junsuk123/MacintoshMini/docs/assets/esp32s3169.png

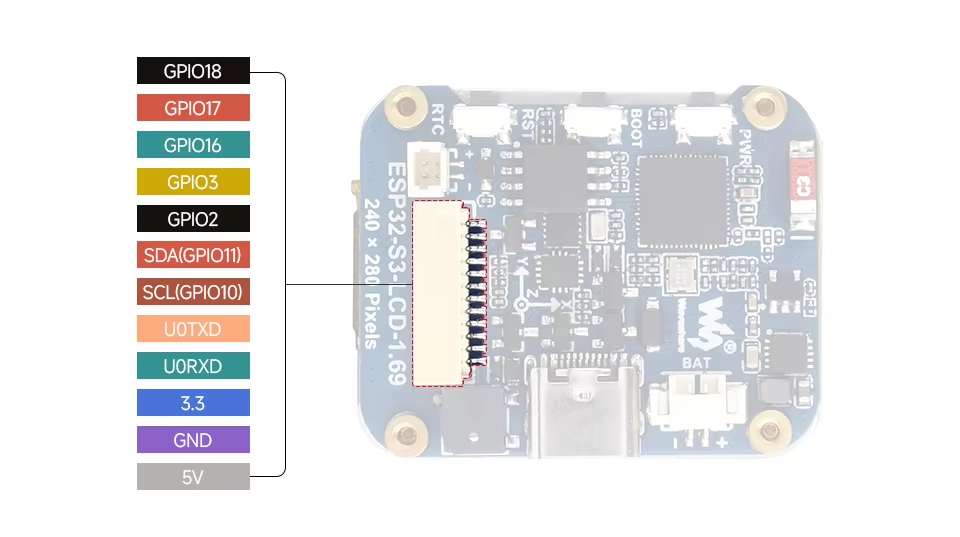
docs/assets/esp32s3169.png
