junsuk123/MacintoshMini/docs/assets/max98357A.png

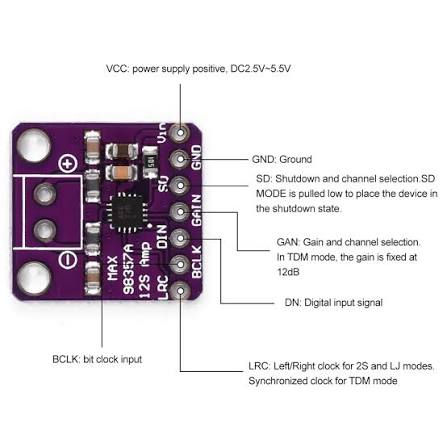
docs/assets/max98357A.png
