junsuk123/MacintoshMini/docs/assets/microSDReader.png

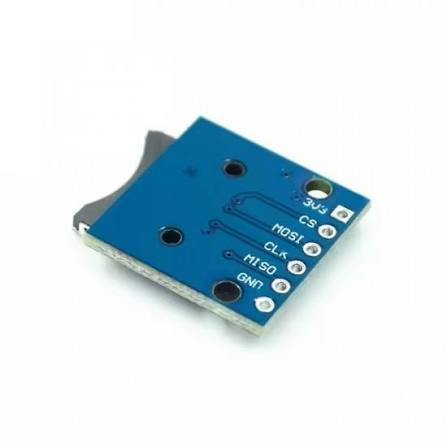
docs/assets/microSDReader.png
