junsuk123/MacintoshMini/(list of files, drawings)

Other design files:
매킨토시Sketch.fzz
