junsuk123/MacintoshMini/firmware/include/config.h

#pragma once

#include <Arduino.h>

namespace cfg {

constexpr uint32_t SerialBaud = 115200;
constexpr uint8_t VideoFps = 25;
constexpr bool LoopPlaylist = true;
constexpr bool DeepSleepWhenDone = false;

constexpr int PinButtonPause = -1;
constexpr int PinButtonNext = -1;

constexpr int PinPowerHold = 41;
constexpr int PinPowerButton = 40;
constexpr int PinBuzzer = 42;
constexpr bool UseBoardV2PowerPins = true;

constexpr int PinSdCs = 3;
constexpr int PinSdMosi = 16;
constexpr int PinSdSck = 17;
constexpr int PinSdMiso = 18;
constexpr uint32_t SdFrequency = 40000000;

constexpr int PinTftBl = 15;
constexpr int PinTftDc = 4;
constexpr int PinTftCs = 5;
constexpr int PinTftRst = 8;
constexpr int PinTftMosi = 7;
constexpr int PinTftSck = 6;
constexpr int PinTftMiso = -1;
constexpr int TftRotation = 0;
constexpr int TftWidth = 240;
constexpr int TftHeight = 280;
constexpr int TftOffsetX = 0;
constexpr int TftOffsetY = 20;
constexpr uint32_t TftFrequency = 80000000;

constexpr int PinI2sBclk = 2;
constexpr int PinI2sLrck = 44;
constexpr int PinI2sData = 43;
constexpr uint32_t DefaultAudioRate = 44100;

// --- IMU (QMI8658) tilt-based volume control ---
// I2C bus shared with the onboard QMI8658 6-axis IMU (addr 0x6B). GPIO10/11 are
// unused by the video/audio/SD paths. Pins follow the Waveshare reference design;
// verify against the board schematic. If WHO_AM_I fails at boot the volume task
// disables itself and playback continues normally.
constexpr int PinI2cSda = 11;
constexpr int PinI2cScl = 10;
constexpr uint8_t ImuI2cAddress = 0x6B;

constexpr uint32_t ImuPollIntervalMs = 20;      // 50 Hz accel sampling
constexpr float ImuFilterAlpha = 0.15f;         // EMA low-pass on accel (lower = smoother/slower)
constexpr float VolumeDeadzoneDeg = 15.0f;      // off zone: tilt within this of baseline = control OFF
constexpr uint32_t VolumeStepIntervalMs = 500;  // step interval just past the dead zone (slowest)
constexpr float VolumeStep = 0.05f;             // 0..1 setting change per step (20 steps full range)
// Tilt farther past the dead zone to change volume faster: the step interval
// shrinks from VolumeStepIntervalMs toward VolumeStepIntervalMinMs as the tilt
// grows from the dead-zone edge to VolumeFullSpeedDeg beyond it. Step size stays
// VolumeStep, so far tilt just steps more often (finer control near the edge).
constexpr float VolumeFullSpeedDeg = 45.0f;       // extra tilt past the dead zone that reaches max speed
constexpr uint32_t VolumeStepIntervalMinMs = 120; // fastest step interval at/above full-speed tilt
constexpr float VolumeInitial = 0.70f;          // startup volume setting (pre perceptual curve)
constexpr bool ImuVolumeInvert = false;         // flip if clockwise lowers instead of raises volume
constexpr uint32_t VolumeOverlayLingerMs = 1200; // keep the on-screen bar visible this long after activity

// --- Buzzer haptic feedback on volume steps (magnetic buzzer on GPIO42) ---
// Driven far below the buzzer's ~2-4 kHz resonance to favor a low tactile "tick"
// over an audible beep. A coil buzzer has little moving mass, so expect a faint
// click you mostly hear -- not vibration-motor-grade haptics. Tune freq/duration
// on-device. Up ticks slightly higher than down so direction is distinguishable.
constexpr bool BuzzerHapticEnable = true;
constexpr int BuzzerLedcChannel = 4;             // LEDC channel dedicated to the buzzer
constexpr uint32_t BuzzerHapticFreqUpHz = 70;    // volume-up tick pitch
constexpr uint32_t BuzzerHapticFreqDownHz = 45;  // volume-down tick pitch (lower = deeper)
constexpr uint32_t BuzzerHapticMs = 25;          // tick duration
// Tick loudness scales with the current volume. The buzzer is a PWM square wave
// whose loudness tracks duty cycle, peaking at 50% (512 of the 10-bit 0..1023
// range); past 50% it quiets again, so 512 is the ceiling. Duty is interpolated
// between Min (faint floor near zero volume) and Max in proportion to the volume.
constexpr uint32_t BuzzerHapticMaxDuty = 512;    // duty at full volume (50% = loudest)
constexpr uint32_t BuzzerHapticMinDuty = 24;     // duty floor so a step is still felt at low volume

// --- Shake-to-pause (up/down shake toggles playback pause) ---
// The IMU task projects the dynamic (gravity-removed) acceleration onto the
// gravity vector to isolate vertical motion, then counts alternating threshold
// crossings. A deliberate up/down shake toggles pause via the same path as the
// pause button, so audio and video stop together and resume in sync. Thresholds
// are in raw accel LSB (accel is +-2g full scale, so 1 g ~= 16384 LSB); tune on
// device if shakes trigger too easily or not at all.
constexpr bool ShakePauseEnable = true;
constexpr float ShakeAccelThreshold = 6000.0f;   // vertical dynamic accel to count a crossing (~0.37 g)
constexpr int ShakeCrossingsNeeded = 3;          // alternating up/down crossings that make one gesture
constexpr uint32_t ShakeWindowMs = 700;          // crossings must complete within this span
constexpr uint32_t ShakeCooldownMs = 1200;       // debounce after a toggle; also mutes tilt-volume during a shake

// --- Battery monitoring (ETA6098 charger; BAT_ADC on GPIO1 = ADC1_CH0) ---
// Per the V2 schematic the battery B+ is divided by (R3 + R7) / R7 =
// (200K + 100K) / 100K = 3 into GPIO1. Charging over USB-C is done entirely by
// the ETA6098 in hardware; firmware only samples the level to warn when it is
// low. Voltages are single-cell LiPo. Percent is a rough linear estimate.
constexpr int PinBatteryAdc = 1;
constexpr float BatteryDividerRatio = 3.0f;      // multiply ADC pin voltage by this to get B+
constexpr uint32_t BatterySampleIntervalMs = 2000;
constexpr float BatteryFullVoltage = 4.20f;
constexpr float BatteryEmptyVoltage = 3.30f;
constexpr float BatteryLowVoltage = 3.45f;       // below this -> red lightning charge warning

// Charging is inferred from the battery voltage (no charge-status GPIO exists).
// Plugging in makes B+ jump up (charger drives it / load moves to USB); unplugging
// makes it sag under load. So a positive step between samples (or sitting at/above
// "full") means charging; a negative step (or dropping below "clear") means not.
// Hysteresis holds the state between transients. It's a heuristic, but the
// plug/unplug jump is usually clear, so it flips within ~one sample interval.
constexpr float BatteryChargeFullVoltage = 4.15f;   // at/above -> charging (topped up on charger)
constexpr float BatteryChargeClearVoltage = 3.90f;  // below -> definitely not charging
constexpr float BatteryChargeStepVoltage = 0.03f;   // per-sample jump: + = plugged in, - = unplugged

// --- SD-insertion power control ---
// The product case hides the power/reset buttons, so the SD card drives power.
// REQUIRES a hardware change: wire the SD socket's card-detect switch IN PARALLEL
// WITH THE POWER BUTTON (Key2) so inserting a card pulls the power latch on just
// like a button press (the switch must CLOSE on insert). Power the reader's 3.3V
// directly (not through that switch anymore).
//   Insert card -> hardware powers the board on -> firmware asserts SYS_EN to hold.
//   Remove card -> firmware sees SPI stop responding and releases SYS_EN -> off.
// USB-C charging is independent and always works. On battery, "no card" == truly
// off (zero draw). An electrically-off board cannot be turned on by firmware, so
// the hardware trigger above is mandatory. Set false to keep always-on when powered.
constexpr bool SdPowerControlEnable = true;
constexpr uint32_t SdAbsentPollMs = 500;         // card poll interval while idle on USB power

constexpr BaseType_t AudioCore = 0;
constexpr BaseType_t DecodeCore = 0;
constexpr BaseType_t DrawCore = 1;

constexpr size_t FileNameLimit = 48;
constexpr size_t MaxPlaylistItems = 96;

// --- Optional intro / transition screens (independent of the playlist) ---
// Reserved clip stems, excluded from the auto-scanned playlist. Put
// "<name>.mjpeg" (and optionally "<name>.aac") on the SD card to enable a screen;
// delete the file to disable it and the system skips it silently, no error.
//   Loading    -> plays once at boot, before the playlist
//   Transition -> plays between videos (including the loop wrap), not before the
//                 first video after loading
constexpr char LoadingClipName[] = "Loading";
constexpr char TransitionClipName[] = "Transition";
constexpr size_t ReadBufferSize = 8192;
constexpr size_t JpegFrameBufferSize = 240 * 280 * 2 / 5;
constexpr size_t DecodeBufferCount = 3;
constexpr size_t MaxMcuPixels = 16 * 16 * 8;

// Full-frame RGB565 buffers in PSRAM: whole frame decoded once, then pushed to
// the panel in a single large transfer instead of many small per-MCU writes.
// Source frame size produced by the converter. Default output is 240x200; if you
// change the converter's resolution, set these to match so the buffers/decoder
// line up (mismatched sources are clipped, not garbled).
constexpr int VideoFrameWidth = 240;
constexpr int VideoFrameHeight = 200;
// Top/bottom margins (case bezel) in panel pixels. All on-screen content is
// pushed down by VideoTopMargin, and the video is fitted into the space between
// the two margins. Panel is 280 px tall. Tune these to match your case.
constexpr int VideoTopMargin = 40;
constexpr int VideoBottomMargin = 40;
// Fit the source frame into the visible window (between the margins), preserving
// aspect ratio (no distortion) and centering. A source that already matches the
// window is drawn natively (no scaling). 240x200 into a 240x200 window fits 1:1.
constexpr int VideoWindowW = TftWidth;                                        // 240
constexpr int VideoWindowH = TftHeight - VideoTopMargin - VideoBottomMargin;   // 280-40-40 = 200
constexpr bool VideoWidthLimited =
    VideoFrameWidth * VideoWindowH >= VideoFrameHeight * VideoWindowW;
constexpr int VideoDrawWidth =
    VideoWidthLimited ? VideoWindowW : (VideoFrameWidth * VideoWindowH / VideoFrameHeight);
constexpr int VideoDrawHeight =
    VideoWidthLimited ? (VideoFrameHeight * VideoWindowW / VideoFrameWidth) : VideoWindowH;
constexpr int VideoDrawX = (TftWidth - VideoDrawWidth) / 2;               // center horizontally
constexpr int VideoDrawY = VideoTopMargin + (VideoWindowH - VideoDrawHeight) / 2;  // center vertically
// One buffer is held by the draw task as the last-shown frame (so the volume
// overlay can be refreshed over it while paused), leaving three to cycle through
// the decode/draw pipeline -- same jitter headroom as the original triple buffer.
constexpr size_t RgbFrameCount = 4;

constexpr uint32_t ButtonDebounceMs = 180;
constexpr uint32_t TelemetryIntervalMs = 2000;

}  // namespace cfg
