junsuk123/MacintoshMini/(commit log)

2023-09-19 프로젝트 시작
2023-09-19 메모리 관련 수정
2023-09-21 메모리 관련 문제 해결 중
2023-09-24 메모리 관련 이슈 해결 중 : displaying() 태스크 분해
    [매킨토시Sketch.fzz, 메모리 할당 테스트.xlsx]
2023-09-24 메모리 관련 이슈 해결 중 : 헤더파일 내 drawTask 할당 메모리 줄여 이미지 출력 확실하게 됨(동영상 재생은 아직 오류 발생)
2023-09-25 메모리 관련 이슈 해결 중 : 출력이 규칙적으로 되지 않는 것 같음. 파일 읽는 과정에서 문제가 있는 것으로 예상됨
2023-09-25 메모리 관련 이슈 해결 중 : 메모리 관련 변수들을 변경해가며 디코딩 된 프레임수를 분석하는 중
    [메모리 할당 테스트.xlsx]
2023-11-23 맥 배포용 파일 구성
    [매킨토시Sketch.fzz]
2023-11-24 아두이노 코드와 window 파일변환기 약간 수정
2023-12-05 오디오와 비디오에서 클릭 이벤트 동시처리가 가능하도록 코드 수정
2023-12-21 오디오 태스크 메인코드에 통합을 위한 준비
2023-12-21 Remove Window용.zip from tracking
2026-07-20 Add firmware with optimized MJPEG video pipeline
    Bring the Macintosh Mini ESP32-S3 firmware up to stable 25fps playback with
    all modules (LCD, MAX98357 I2S audio, MicroSD) verified on hardware.
    SD:
    - Correct SD pins to actual wiring (cs=3, sck=17, miso=18, mosi=16)
    - Low-level CMD0/CMD8 probe + escalating-frequency mount diagnostics
    - MISO internal pull-up; mount high-speed-first (40MHz) with fallback
    Video pipeline:
    - Full-frame RGB565 triple buffering in PSRAM; one large SPI transfer per
    frame instead of many per-MCU writes
    - Remove per-byte File::available() in the frame reader (the real bottleneck:
    cut per-frame read from ~74ms to ~7ms), lifting playback 5.5fps -> 25fps
    Stability: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
    [partitions.csv]
2026-07-20 Rewrite file converter as a threaded Tkinter GUI
    Replace the dialog-only converter with a real window: multi-file list,
    output-folder picker, settings (fps/quality/audio bitrate/volume), a live
    progress bar driven by ffmpeg -progress, a log pane, and cancel — all run on
    a background thread so the UI stays responsive.
    Fix bugs in the original (preserved as converter_legacy.py):
    - missing `import sys` (get_current_path raised NameError)
    - mixed tab/space indentation
    - duplicate -filter:a that silently dropped loudnorm
    - brittle shell=True string interpolation -> argument lists
    Output is aligned to firmware expectations: 240x240 baseline JPEG
    (format=yuvj420p, scale+crop for any aspect) and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
2026-07-20 Rebuild Windows converter with the new GUI
    Regenerate 영상변환기.exe and _internal via PyInstaller 6.11 from the rewritten
    converter.py. ffmpeg.exe is bundled at _internal/ffmpeg.exe (matching the app's
    lookup path). The _internal churn is the tcl/tk restructure between the previous
    and current PyInstaller/Python versions.
    Verified: the built exe launches (window "Mini Macintosh 파일 변환기") without error.
2026-07-21 Add IMU shake-to-pause with synced audio/video resume
    Shaking the device up and down now toggles playback pause. Vertical
    motion is isolated by projecting the gravity-removed acceleration onto
    the gravity vector, so the gesture is orientation-independent and rejects
    sideways/in-out shakes. The shake raises an edge flag consumed by
    playClip through the same path as the pause button, so the audio task's
    exact byte position is held and the video pacing clock is shifted by the
    paused duration -- both stop together and resume from the same instant in
    sync. Tilt-volume is held steady while a shake is in progress or during
    the post-trigger cooldown. Shake tuning lives in config.h Shake* constants.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
2026-07-21 Volume UX: tilt-scaled speed, volume-proportional buzzer, pause-time OSD
    - Buzzer tick loudness now scales with the current volume by varying the
    LEDC PWM duty (peaks at 50%), so the click tracks the level it reports.
    - Show and refresh the volume bar while paused: the draw task retains the
    last frame and redraws it (self-erasing the old bar) with the overlay on
    the queue-receive timeout, since no frames flow during pause. RgbFrameCount
    bumped 3->4 so the cycling pool keeps its triple-buffer headroom.
    - Tilt farther past the dead zone to change volume faster: the step interval
    shrinks from VolumeStepIntervalMs toward VolumeStepIntervalMinMs with tilt
    magnitude, keeping the 0.05 s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
    [config.h, main.cpp]
2026-07-21 Add one-click Windows converter distribution (LFS zip)
    파일변환기/Window용.zip contains a self-bootstrapping distribution: the
    user double-clicks 실행.bat, which on first run installs PyInstaller and
    builds a standalone converter.exe with ffmpeg bundled into _internal,
    then launches it. Subsequent clicks run the built exe directly (no
    Python needed). Ship source/converter.py, source/build_and_run.py and a
    bundled ffmpeg.exe; the built app/ folder is produced on the user's
    machine. Tracked via Git LFS; .gitignore updated to keep just this zip.
    Document the download and one-click flow in the README.
2026-07-21 Converter: configurable output resolution (default 240x200)
    - GUI converter: replace the fixed 240x240 with editable width/height
    fields defaulting to 240x200; scale/crop uses them. Rebuilt the LFS
    distribution zip and refreshed the screenshot.
    - CLI convert_video.py: default --size 240:200 and pad to the chosen size.
    - Firmware: VideoFrameHeight 240 -> 200 to match, and fit the source frame
    into the case-margin window preserving aspect ratio (no square-scaling
    distortion), centering horizontally and vertically. 240x200 lands 1:1 in
    the 240x200 window (top/bottom margins 40).
    - README: document the configurable resolution and the firmware-match note.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
    [config.h, main.cpp]
2026-07-21 Converter: accept .mjpeg input for re-scaling
    Feeding an already-converted .mjpeg now re-scales it to the chosen
    resolution (video only; audio untouched). The mjpeg demuxer is given an
    input frame rate, and when the output path equals the input it is written
    to a temp file and swapped in so the source isn't corrupted mid-read.
    Rebuilt the LFS distribution zip; documented in the README.
2026-07-21 Converter: ship a pre-built Windows executable
    Bundle a PyInstaller-built app/converter.exe (with ffmpeg embedded) in the
    distribution so it runs on double-click with no Python or first-run build.
    실행.bat just launches app/converter.exe; source/converter.py kept for
    reference. Single ffmpeg copy (inside the exe). README/사용법 updated.
2026-07-21 Converter: fix 실행.bat encoding (garbled Korean, run failure)
    The launcher had Korean text and LF line endings, which Korean Windows
    cmd (codepage 949) misread -- printing mojibake and trying to execute the
    garbled words. Rewrote 실행.bat as pure ASCII with CRLF and no BOM so it
    runs on any codepage; verified it launches app/converter.exe.
2026-07-21 docs: sync README with current features
    Document battery gauge + low-battery warning, full-screen charging
    display, SD-insertion power control, case-margin video fitting, and the
    product assembly wiring notes (amp VIN->3.3V for battery sound, card-detect
    -> power button, battery ADC, reset-on-battery caveat). Reflect the
    pre-built Windows converter distribution in the project layout, add the
    BAT_ADC pin and the new config knobs.
